MandIProject/Smart-Energy-Meter/IMG_20201020_141054.jpg

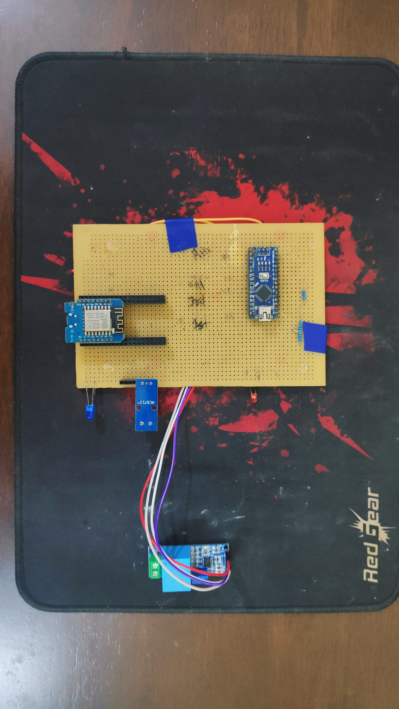
IMG_20201020_141054.jpg
